HellbeE908/SPECTER/SPECTER/media/Cad_Render/3D Scanner_7.png

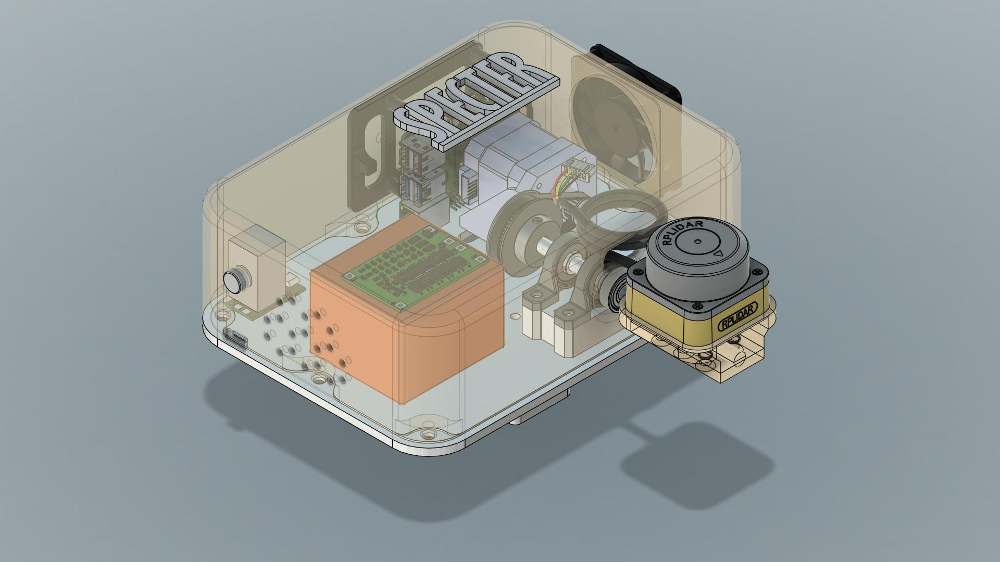
SPECTER/media/Cad_Render/3D Scanner_7.png
