HellbeE908/SPECTER/SPECTER/media/Cad_Render/3D Scanner_4.png

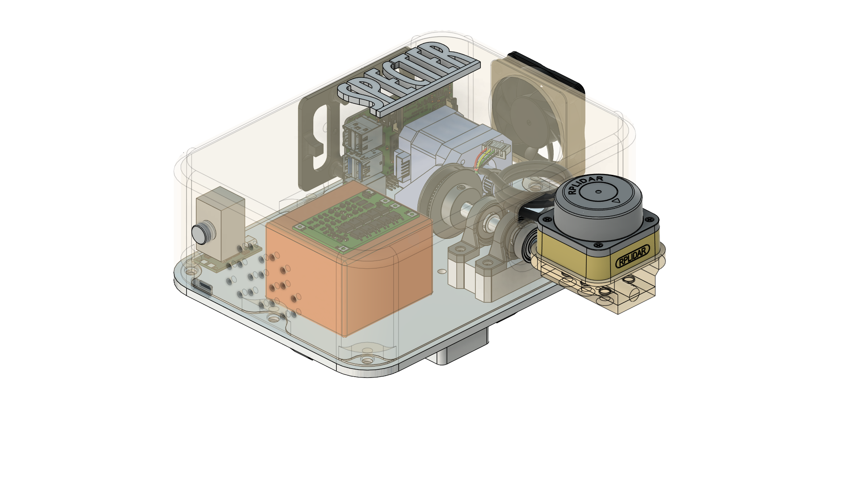
SPECTER/media/Cad_Render/3D Scanner_4.png
