HellbeE908/SPECTER/SPECTER/media/README.md

# Media

The main README expects these two files (rename your renders to match, or edit the README):
- `park_survey_1.2M.jpg` (4-station park render)
- `room_scan_250k.jpg` (room cutaway render)

Also add:
- `build/` photos of printing, wiring and assembly, team members with ID badges visible
- `cad/` the Fusion 360 renders
- `scans/` more CloudCompare renders

Keep each image under about 5 MB (export JPEGs at 80-90% quality).
