HellbeE908/SPECTER/SPECTER/hardware/cad/README.md

# CAD

Fusion Cad Files for SPECTER - https://drive.google.com/file/d/1O5i6Pvk-fFctnKc7o0LwosFKkcXh7XCx/view?usp=sharing
