HellbeE908/SPECTER/SPECTER/media/Cad_Render/3D Scanner.png

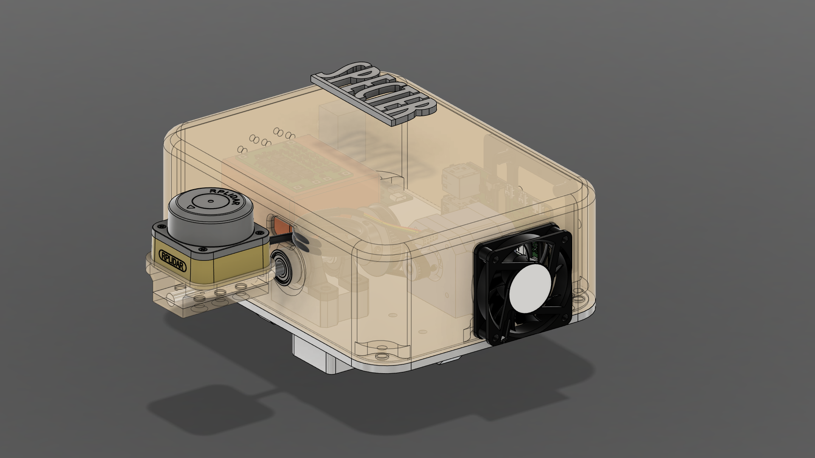
SPECTER/media/Cad_Render/3D Scanner.png
