HellbeE908/SPECTER/SPECTER/media/Cad_Render/3D Scanner_3.png

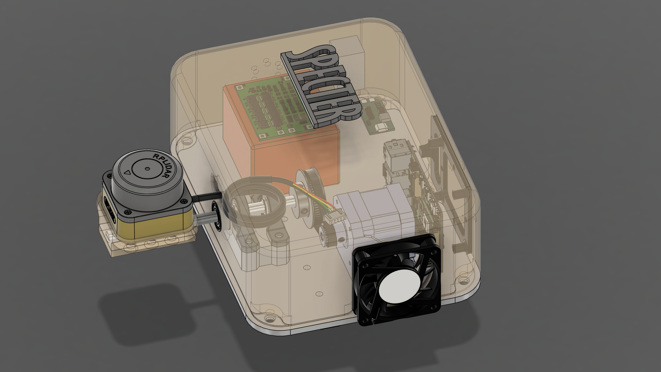
SPECTER/media/Cad_Render/3D Scanner_3.png
