HellbeE908/SPECTER/SPECTER/media/Cad_Render/3D Scanner_9.png

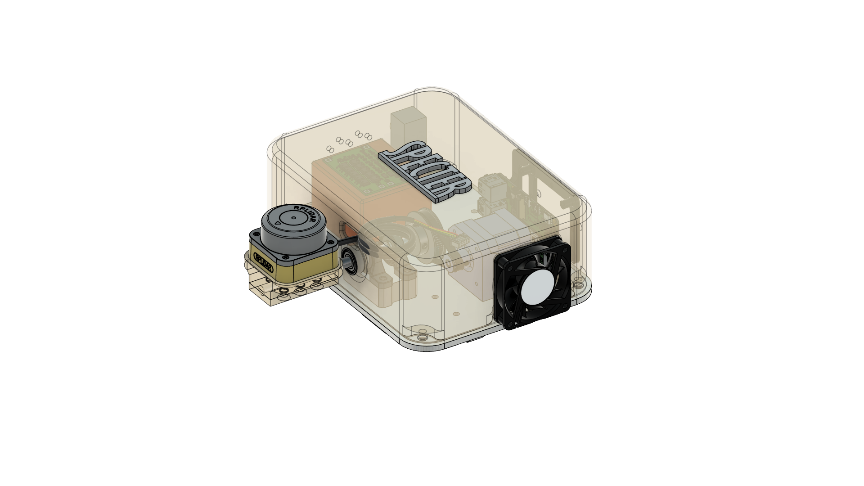
SPECTER/media/Cad_Render/3D Scanner_9.png
