HellbeE908/SPECTER/SPECTER/media/Cad_Render/Screenshot 2026-10-21 193201.png

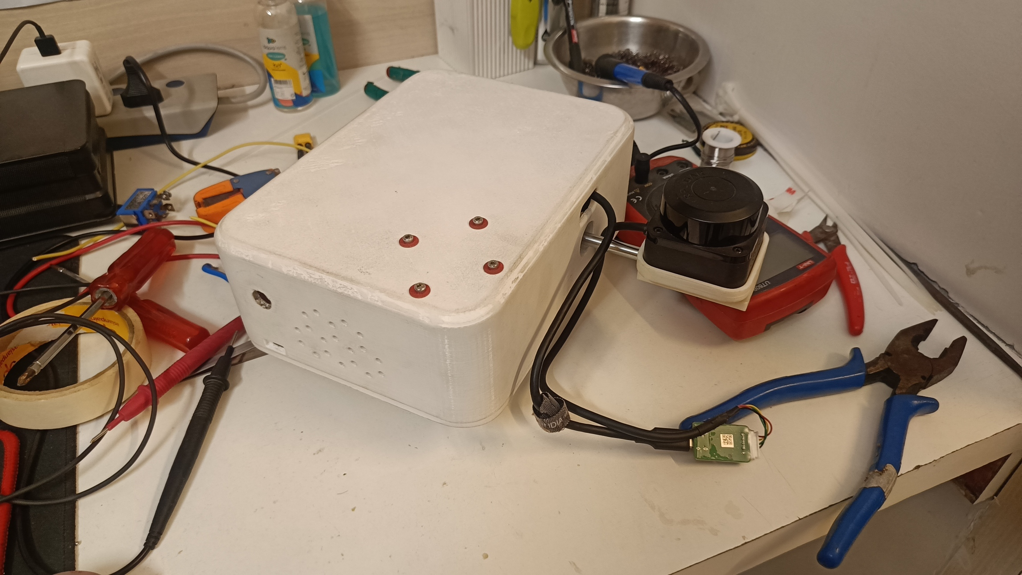
SPECTER/media/Cad_Render/Screenshot 2026-10-21 193201.png
