HellbeE908/SPECTER/SPECTER/media/Park_Render/Render1-1.1M.jpg

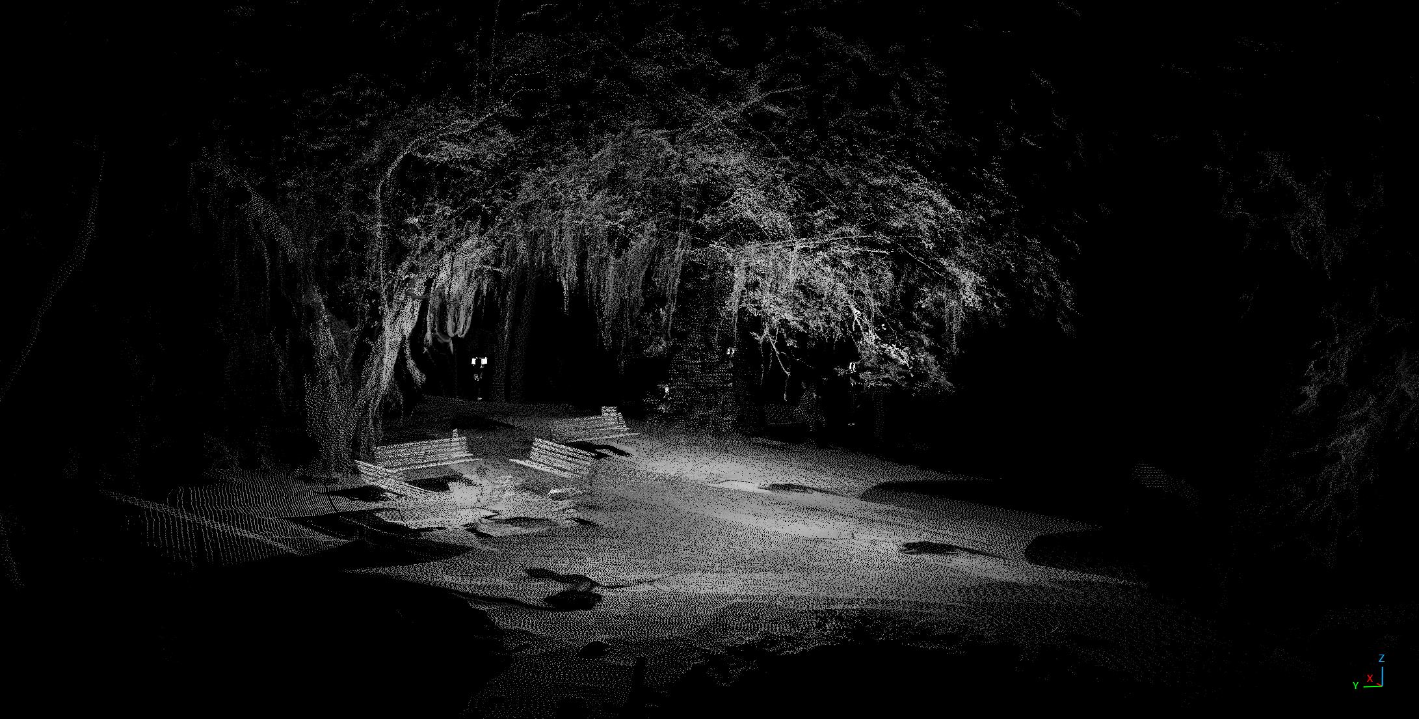
SPECTER/media/Park_Render/Render1-1.1M.jpg
