HellbeE908/SPECTER/SPECTER/media/Park_Render/Render2-1.1M.jpg

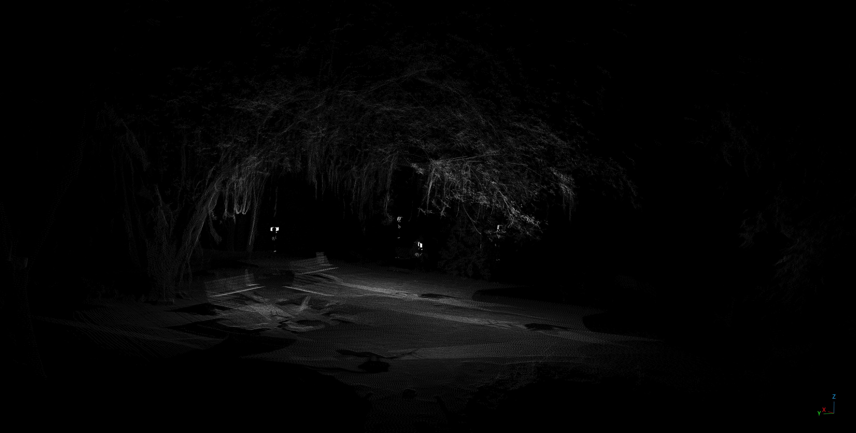
SPECTER/media/Park_Render/Render2-1.1M.jpg
