HellbeE908/SPECTER/SPECTER/media/Park_Render/Render3-1.1M.jpg

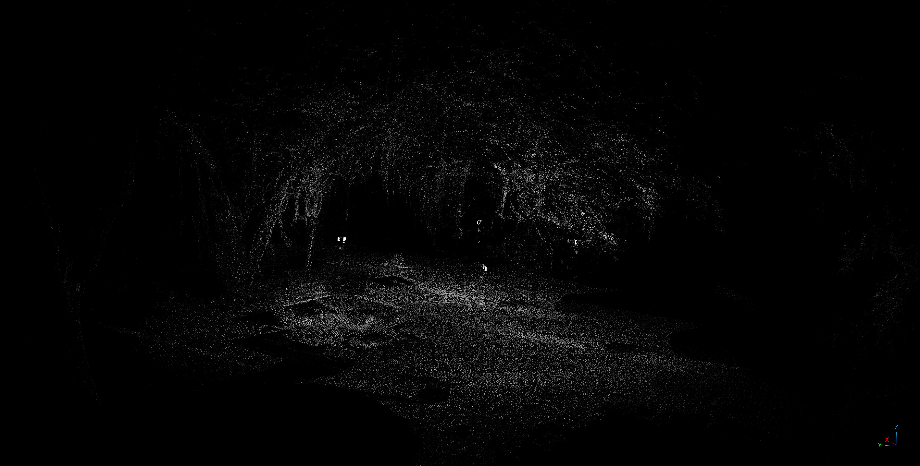
SPECTER/media/Park_Render/Render3-1.1M.jpg
