HellbeE908/SPECTER/SPECTER/media/Room_Render/Render30-250k.jpg

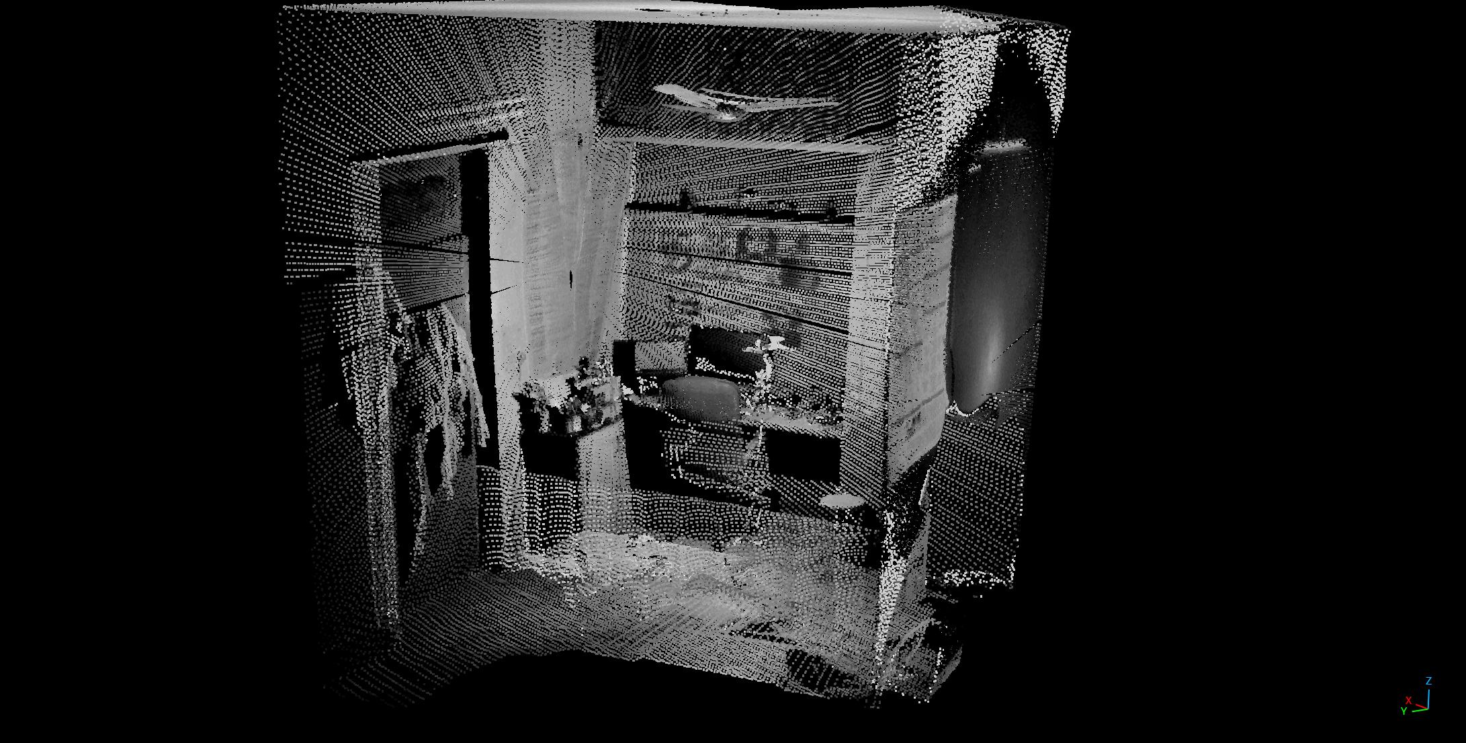
SPECTER/media/Room_Render/Render30-250k.jpg
