HellbeE908/SPECTER/SPECTER/media/Room_Render/Render31-250k.jpg

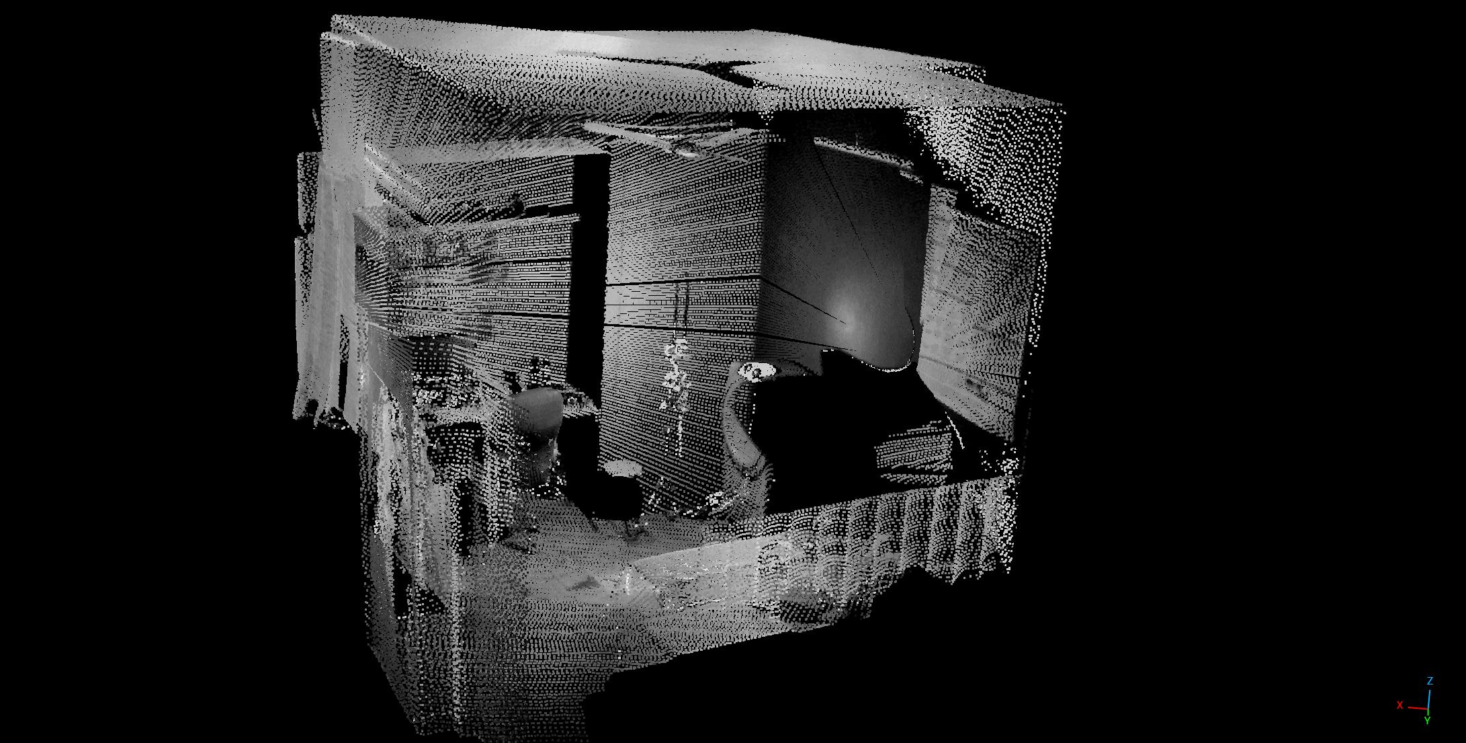
SPECTER/media/Room_Render/Render31-250k.jpg
