HellbeE908/SPECTER/SPECTER/media/Room_Render/Render33-250k.jpg

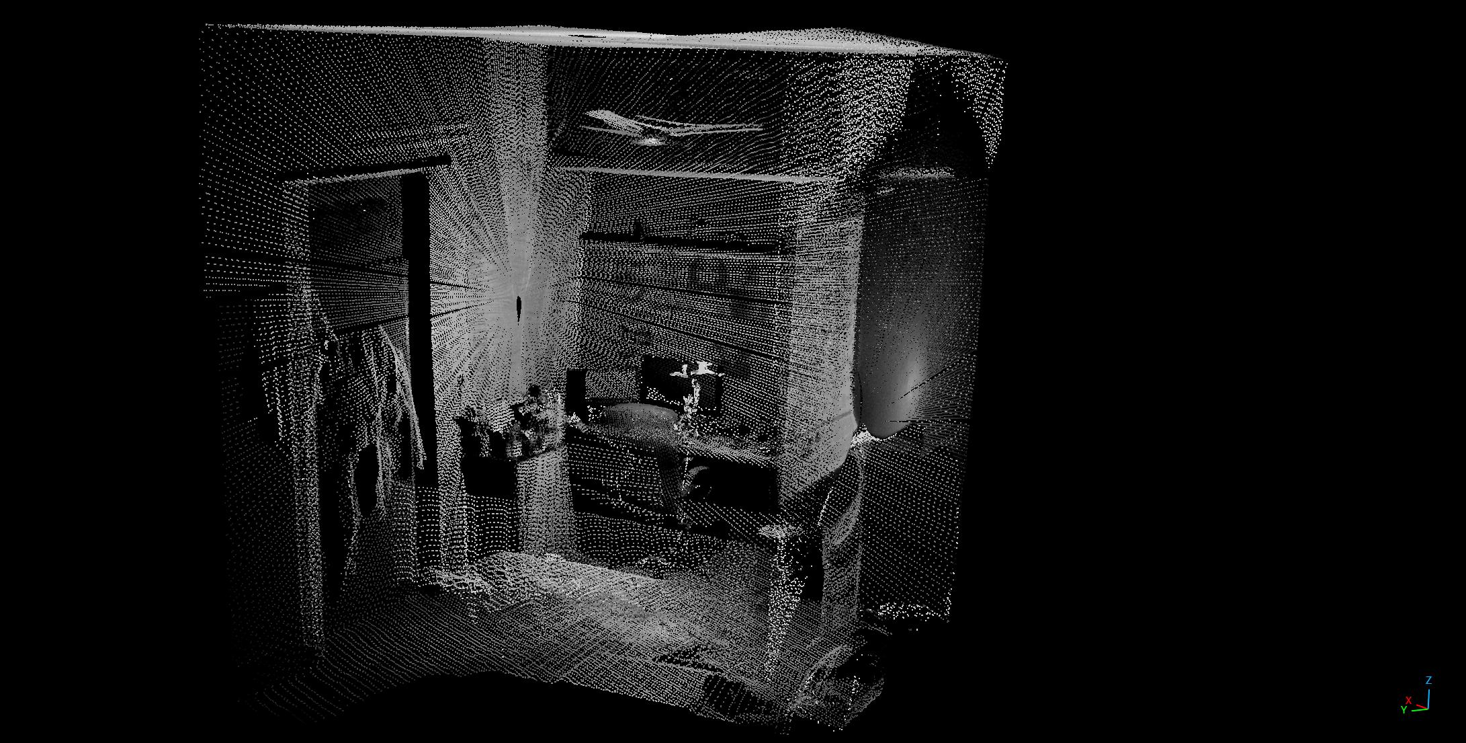
SPECTER/media/Room_Render/Render33-250k.jpg
