HellbeE908/SPECTER/(commit log)

2026-10-23 Update BOM file path in README.md
2026-10-23 Replace file instructions with Fusion Cad link
    Updated README to include link for Fusion Cad files.
2026-10-23 Request to add wiring diagram image in README
    Suggest adding a wiring diagram image to the README.
